Shadow220108/rin/docs/rin_poster.pdf

## R I N

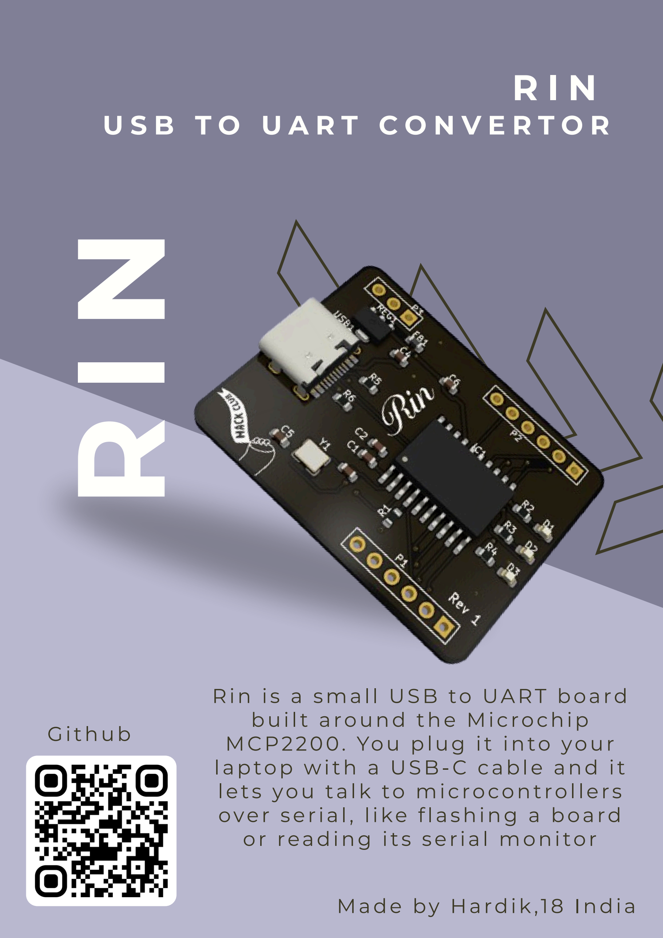
[picture p11: page 1]

# R I N

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

U S B T O U A R T C O N V E R T O R

M a d e by H a rd i k ,1 8 I n d i a

G i t h u b
