Shadow220108/rin/production/v2/rin_bom.csv

Designator | Footprint | Quantity | Value | LCSC Part #
C1 | 0603 | 1 | 10uF
C2, C3 | 0402 | 2 | 1uF
C4, C5 | 0402 | 2 | 100nF
D1 | 0603 | 1 | TX Green
D2 | 0603 | 1 | RX Orange
D3 | 0603 | 1 | PWR Blue
F1 | 1206 | 1 | 500mA hold (1206)
J1 | USB_C_Receptacle_HRO_TYPE-C-31-M-12 | 1 | USB-C
J2 | PinHeader_1x06_P2.54mm_Vertical | 1 | FTDI 6-pin
J3 | PinHeader_1x03_P2.54mm_Vertical | 1 | ESP32 EN/IO0
Q1, Q2 | SOT-23 | 2 | MMBT3904
R1, R2 | 0402 | 2 | 5.1K
R3, R6, R7 | 0402 | 3 | 1K
R4, R5 | 0402 | 2 | 470R
R8, R9 | 0402 | 2 | 10K
SW1 | SW_DPDT_CK_JS202011JCQN | 1 | I/O 5V | 3V3
U1 | SOIC-16_3.9x9.9mm_P1.27mm | 1 | CH340C
U2 | SOT-23-6 | 1 | USBLC6-2SC6
U3 | SOT-23-5 | 1 | AP2112K-3.3
