Shadow220108/rin/PCB/v2/rinv2.kicad_pcb

## KiCad design PCB/v2/rinv2.kicad_pcb (2026-11-09)

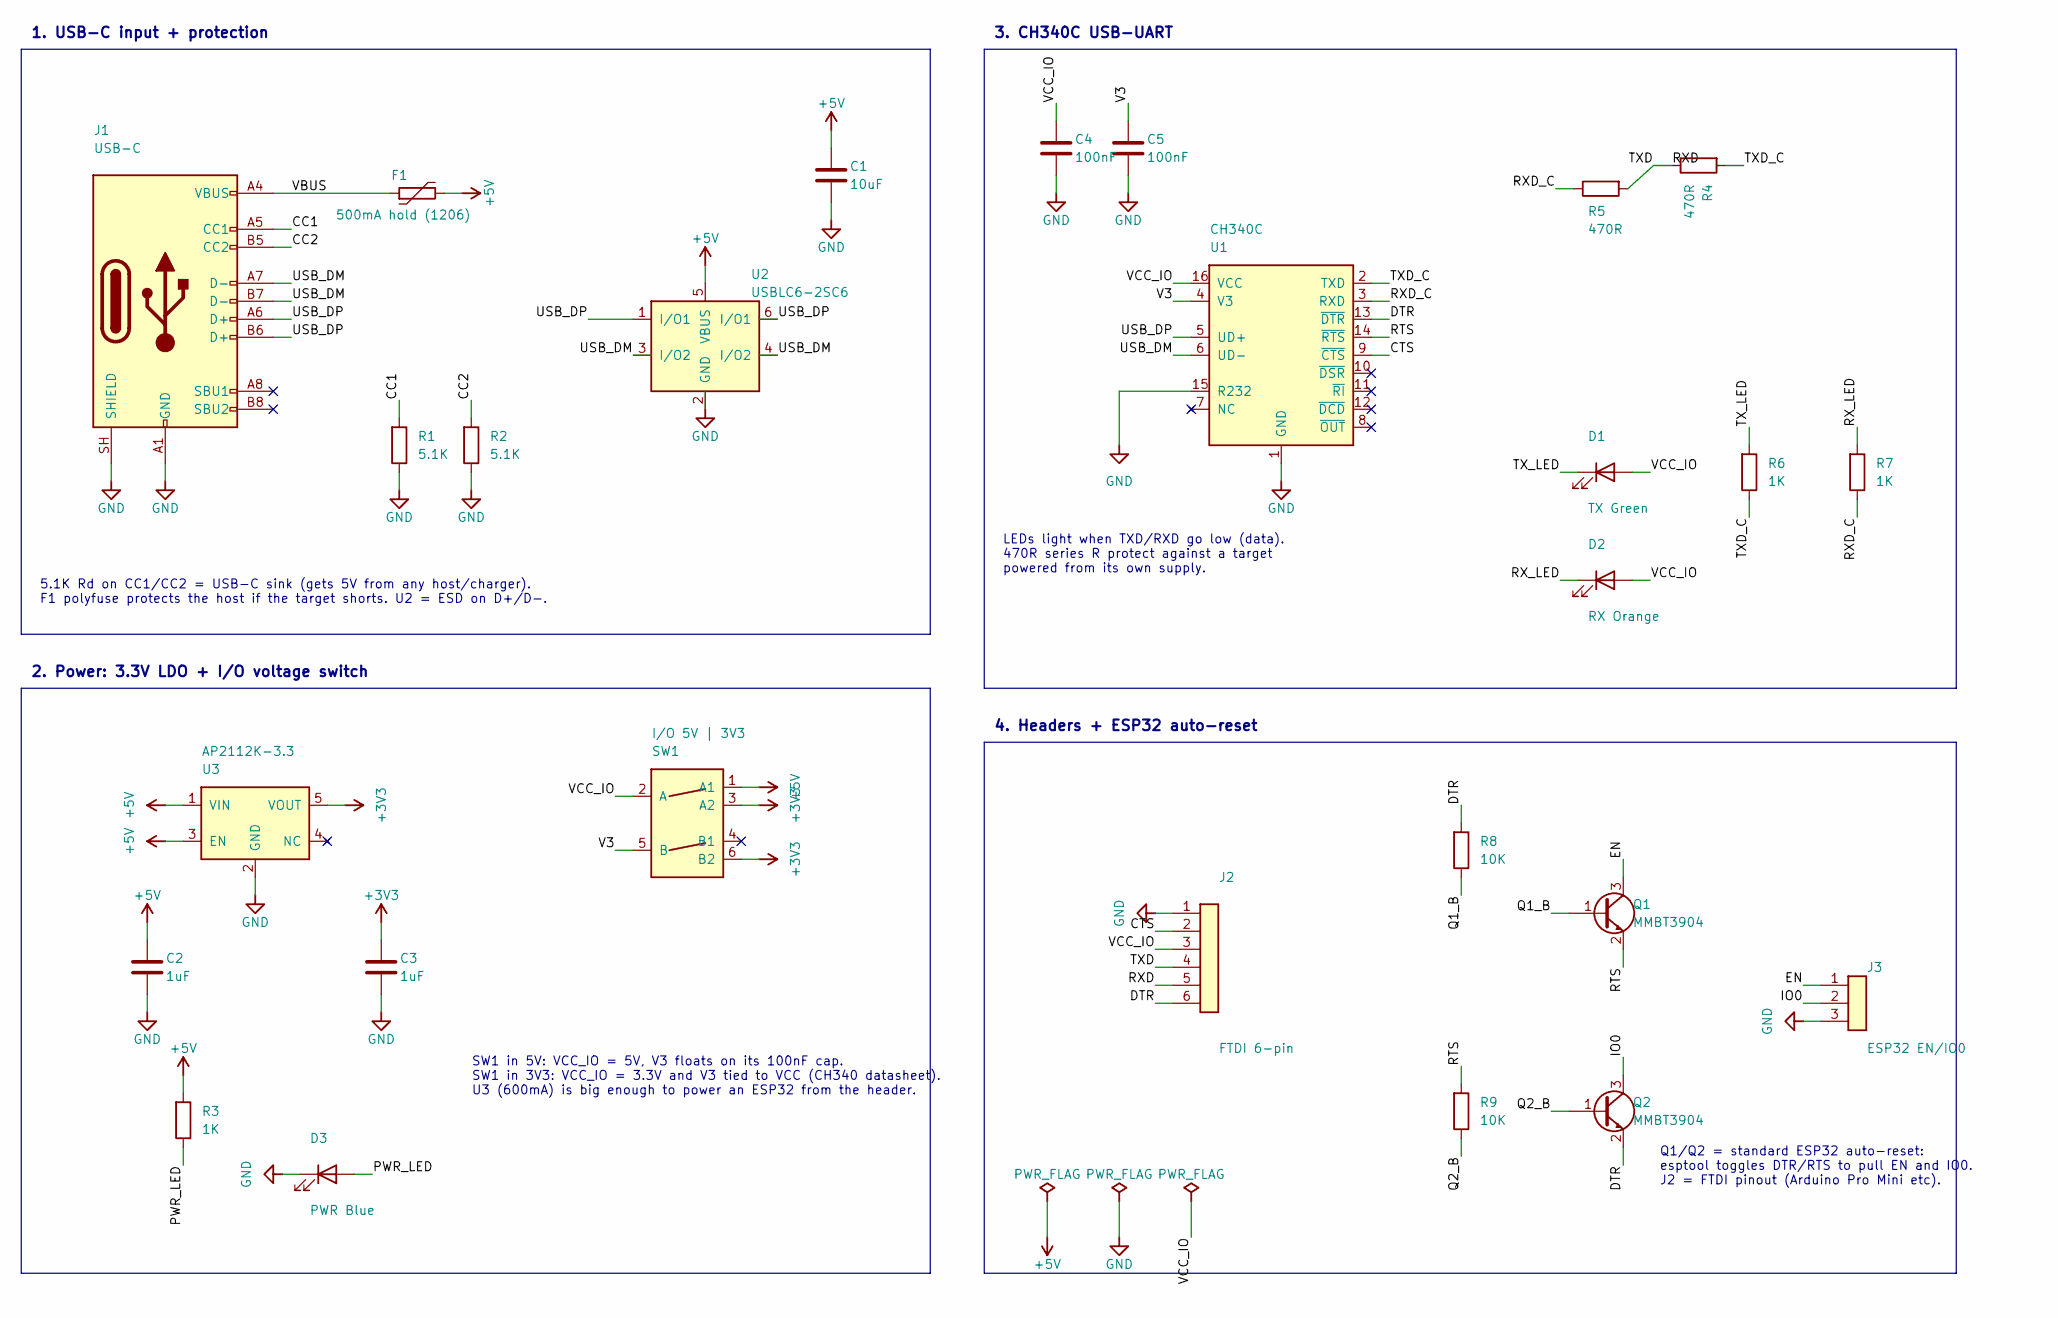
[picture p47: schematic rinv2.kicad_sch, CH340C USB-C to UART with ESP32 auto-reset]

Parts:
C1: 10uF; C_0603_1608Metric
C2, C3: 1uF; C_0402_1005Metric
C4, C5: 100nF; C_0402_1005Metric
D1: TX Green; LED_0603_1608Metric
D2: RX Orange; LED_0603_1608Metric
D3: PWR Blue; LED_0603_1608Metric
F1: 500mA hold (1206); Fuse_1206_3216Metric
J1: USB-C; USB_C_Receptacle_HRO_TYPE-C-31-M-12
J2: FTDI 6-pin; PinHeader_1x06_P2.54mm_Vertical
J3: ESP32 EN/IO0; PinHeader_1x03_P2.54mm_Vertical
Q1, Q2: MMBT3904; SOT-23
R1, R2: 5.1K; R_0402_1005Metric
R3, R6, R7: 1K; R_0402_1005Metric
R4, R5: 470R; R_0402_1005Metric
R8, R9: 10K; R_0402_1005Metric
SW1: I/O 5V | 3V3; SW_DPDT_CK_JS202011JCQN
U1: CH340C; SOIC-16_3.9x9.9mm_P1.27mm
U2: USBLC6-2SC6; SOT-23-6
U3: AP2112K-3.3; SOT-23-5

Connections:
+3V3: C3.1, SW1.3 (A2), SW1.6 (B2), U3.5 (VOUT)
+5V: C1.1, C2.1, F1.2, R3.1, SW1.1 (A1), U2.5 (VBUS), U3.1 (VIN), U3.3 (EN)
CC1: J1.A5 (CC1), R1.1
CC2: J1.B5 (CC2), R2.1
CTS: J2.2, U1.9 (~CTS)
DTR: J2.6, Q2.2 (E), R8.1, U1.13 (~DTR)
EN: J3.1, Q1.3 (C)
GND: C1.2, C2.2, C3.2, C4.2, C5.2, D3.1 (K), J1.A1 (GND), J1.A12 (GND), J1.B1 (GND), J1.B12 (GND), J1.SH (SHIELD), J2.1, J3.3, R1.2, R2.2, U1.1 (GND), U1.15 (R232), U2.2 (GND), U3.2 (GND)
IO0: J3.2, Q2.3 (C)
PWR_LED: D3.2 (A), R3.2
Q1_B: Q1.1 (B), R8.2
Q2_B: Q2.1 (B), R9.2
RTS: Q1.2 (E), R9.1, U1.14 (~RTS)
RXD_C: R5.2, R7.2, U1.3 (RXD)
RX_LED: D2.1 (K), R7.1
TXD_C: R4.1, R6.2, U1.2 (TXD)
TX_LED: D1.1 (K), R6.1
USB_DM: J1.A7 (D-), J1.B7 (D-), U1.6 (UD-), U2.3 (I/O2), U2.4 (I/O2)
USB_DP: J1.A6 (D+), J1.B6 (D+), U1.5 (UD+), U2.1 (I/O1), U2.6 (I/O1)
V3: C5.1, SW1.5 (B), U1.4 (V3)
VBUS: F1.1, J1.A4 (VBUS), J1.A9 (VBUS), J1.B4 (VBUS), J1.B9 (VBUS)
VCC_IO: C4.1, D1.2 (A), D2.2 (A), J2.3, SW1.2 (A), U1.16 (VCC)

Notes on the sheet:
3. CH340C USB-UART
5.1K Rd on CC1/CC2 = USB-C sink (gets 5V from any host/charger). F1 polyfuse protects the host if the target shorts. U2 = ESD on D+/D-.
1. USB-C input + protection
Q1/Q2 = standard ESP32 auto-reset: esptool toggles DTR/RTS to pull EN and IO0. J2 = FTDI pinout (Arduino Pro Mini etc).
LEDs light when TXD/RXD go low (data). 470R series R protect against a target powered from its own supply.
2. Power: 3.3V LDO + I/O voltage switch
SW1 in 5V: VCC_IO = 5V, V3 floats on its 100nF cap. SW1 in 3V3: VCC_IO = 3.3V and V3 tied to VCC (CH340 datasheet). U3 (600mA) is big enough to power an ESP32 from the header.
4. Headers + ESP32 auto-reset

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
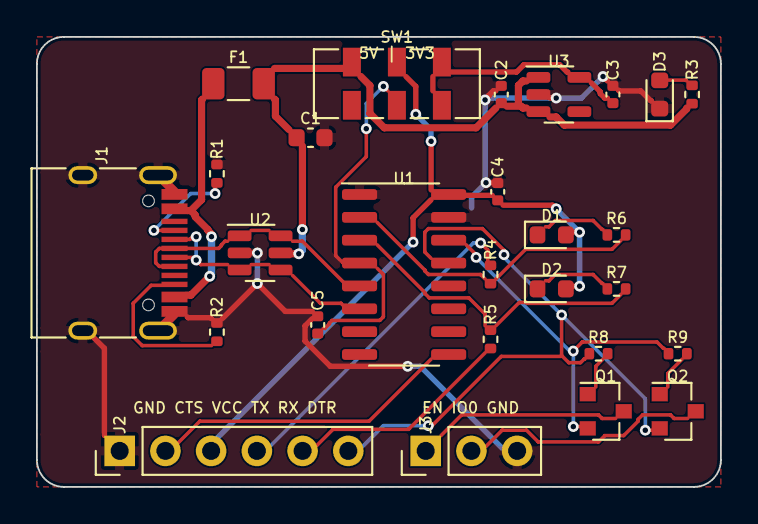
[picture p48: board rinv2.kicad_pcb from above]

Board: 2 copper layers, 38.0 x 25.0 mm, 27 parts (0 on the bottom side), 24 nets.
