Shadow220108/rin/PCB/v1/rin.kicad_pcb

## KiCad design PCB/v1/rin.kicad_pcb (2026-11-08, an earlier design)

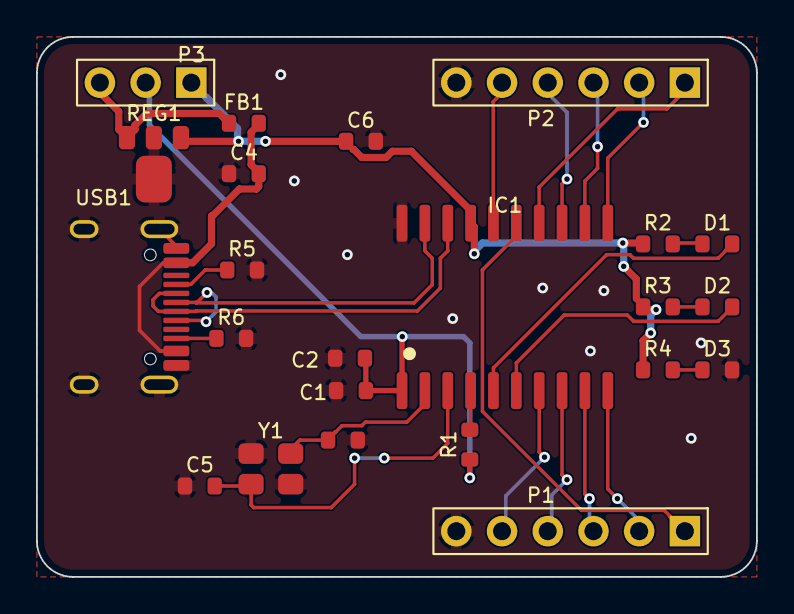
[picture p49: board rin.kicad_pcb from above]

Board: 2 copper layers, 40.0 x 30.0 mm, 23 parts (0 on the bottom side), 27 nets.

Parts:
C1: 2.2uF; C_0603_1608Metric
C2: 100nF; C_0603_1608Metric
C3, C5: 22pF; C_0603_1608Metric
C4: 4.7uF; C_0603_1608Metric
C6: 330nF; C_0603_1608Metric
D1: RX-RED; LED_0603_1608Metric
D2: TX-GREEN; LED_0603_1608Metric
D3: Power-Blue; LED_0603_1608Metric
FB1: FerriteBead; L_0603_1608Metric
IC1: MCP2200-I_SO; SOIC-20W_7.5x12.8mm_P1.27mm
P1, P2: Header 6; PinHeader_1x06_P2.54mm_Vertical
P3: Header 3; PinHeader_1x03_P2.54mm_Vertical
R1: 4.7K; R_0603_1608Metric
R2, R3, R4: 470R; R_0603_1608Metric
R5, R6: 5.1K; R_0603_1608Metric
REG1: RT9166-33GX; SOT-89-3
USB1: USB-C (HRO TYPE-C-31-M-12); USB_C_Receptacle_HRO_TYPE-C-31-M-12
Y1: 12MHz; Crystal_SMD_3225-4Pin_3.2x2.5mm

Connections:
+5VUSB: FB1.1, P3.3, REG1.3
CC1: R5.1, USB1.A5
CC2: R6.1, USB1.B5
CTS: IC1.13, P2.4
D+: IC1.19, USB1.A6, USB1.B6
D-: IC1.18, USB1.A7, USB1.B7
GND: C1.2, C2.2, C3.2, C4.2, C5.2, C6.2, D3.1, IC1.20, P1.6, P2.6, R5.2, R6.2, REG1.2, USB1.A1, USB1.A12, USB1.B1, USB1.B12, USB1.S1, Y1.2, Y1.4
GP0: IC1.16, P2.5
GP1: IC1.15, P1.1
GP2: IC1.14, P2.1
GP3: IC1.9, P1.3
GP4: IC1.8, P1.4
GP5: IC1.7, P1.5
LED_B: D3.2, R4.2
LED_G: D2.2, R3.2
LED_R: D1.2, R2.2
OSC1: C3.1, IC1.2, Y1.3
OSC2: C5.1, IC1.3, Y1.1
RST: IC1.4, R1.2
RTS: IC1.11, P2.2
RX: IC1.10, P1.2
RXLED: D2.1, IC1.6
TX: IC1.12, P2.3
TXLED: D1.1, IC1.5
VBUS_F: C4.1, FB1.2, USB1.A4, USB1.A9, USB1.B4, USB1.B9
VCC: C1.1, C2.1, IC1.1, P3.2, R1.1
VUSB: C6.1, IC1.17, P3.1, R2.1, R3.1, R4.1, REG1.1
