Shadow220108/rin/(commit log)

2026-11-08 Uploading all files from local repo
    [BOM.csv, bom.csv, designators.csv, positions.csv, rin.kicad_pcb, rin.kicad_sch]
2026-11-09 Pushing v2
    [bom.csv, designators.csv, positions.csv, rin.kicad_pcb, rin.kicad_sch, rin_bom.csv, rin_designators.csv, rin_positions.csv]
